MiguelHorta/SmartLeadCharger/presentation/Apresentação Carregador de Baterias.pptx

## Carregador Inteligente de Baterias de Chumbo

Projecto de Eletrónica IV - 4º Ano MIEEET

Professor: Rui Escadas
Autores: Edgar Gonçalves 67590
Miguel Horta 67597

## Objetivos:

- Construir um dispositivo autónomo e de fácil interação com o utilizador capaz de carregar baterias de forma o mais versátil possível;
- Não explodir nada.

## Protótipo:

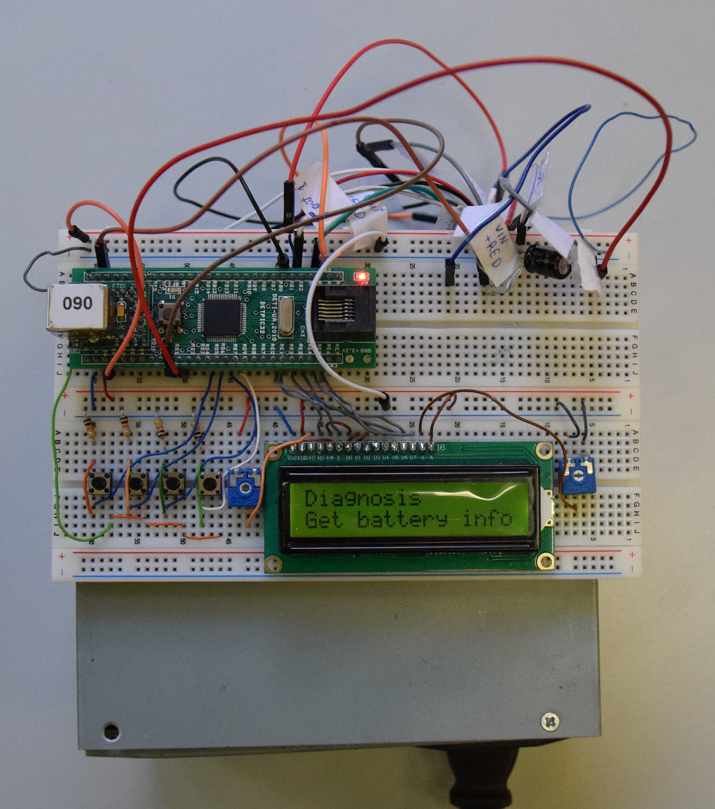
[picture p1: figure]

## Circuitos:

1. Acondicionamento de PWM;
2. Acondicionamento dos sensores de temperatura;
3. Regulador linear de tensão;
4. Fonte de potencia;
Extras:
5. Fonte de 24 V “reutilizada”.

## Acondicionamento de PWM

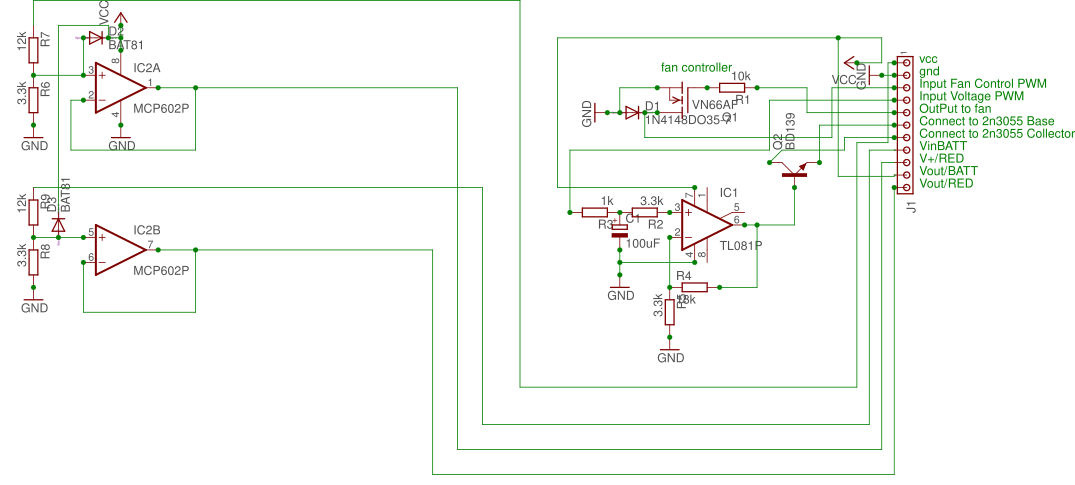
[picture p2: figure]

## Acondicionamento de PWM

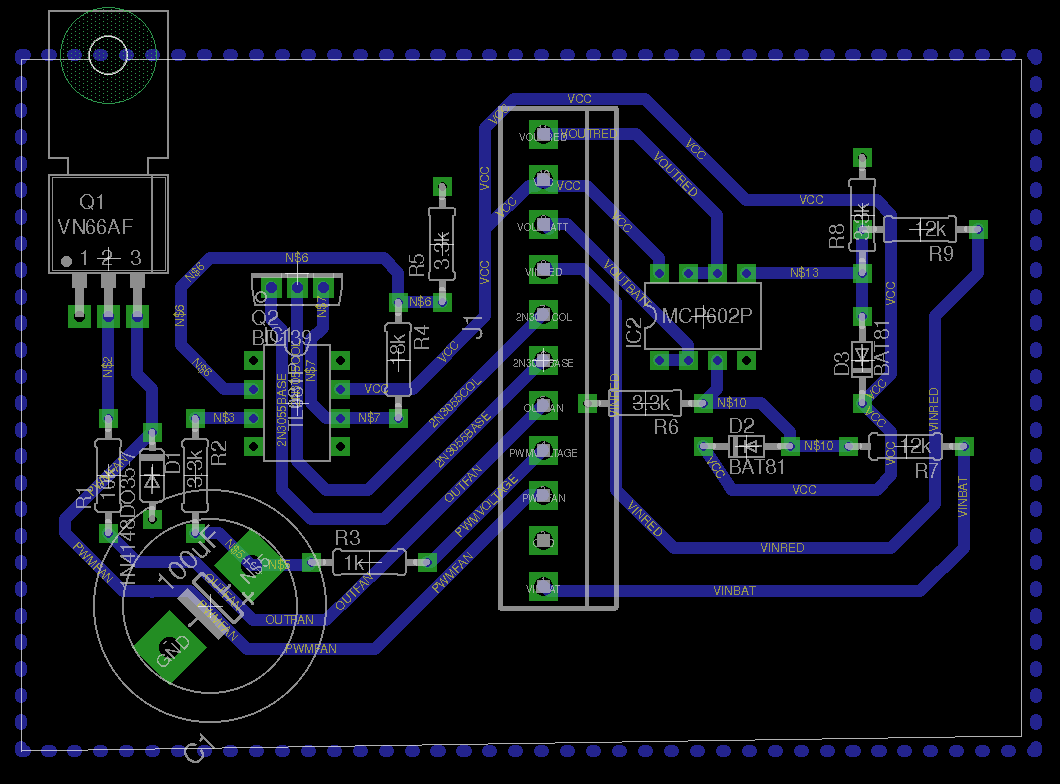
[picture p3: figure]

## Acondicionamento de PWM

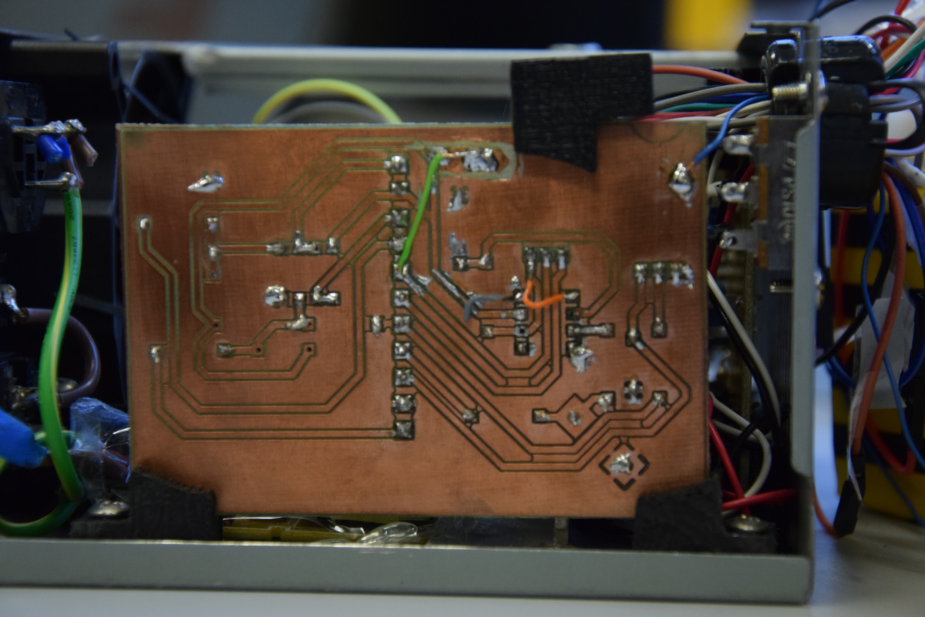
[picture p4: figure]

## 2. Acondicionamento dos sensores de temperatura

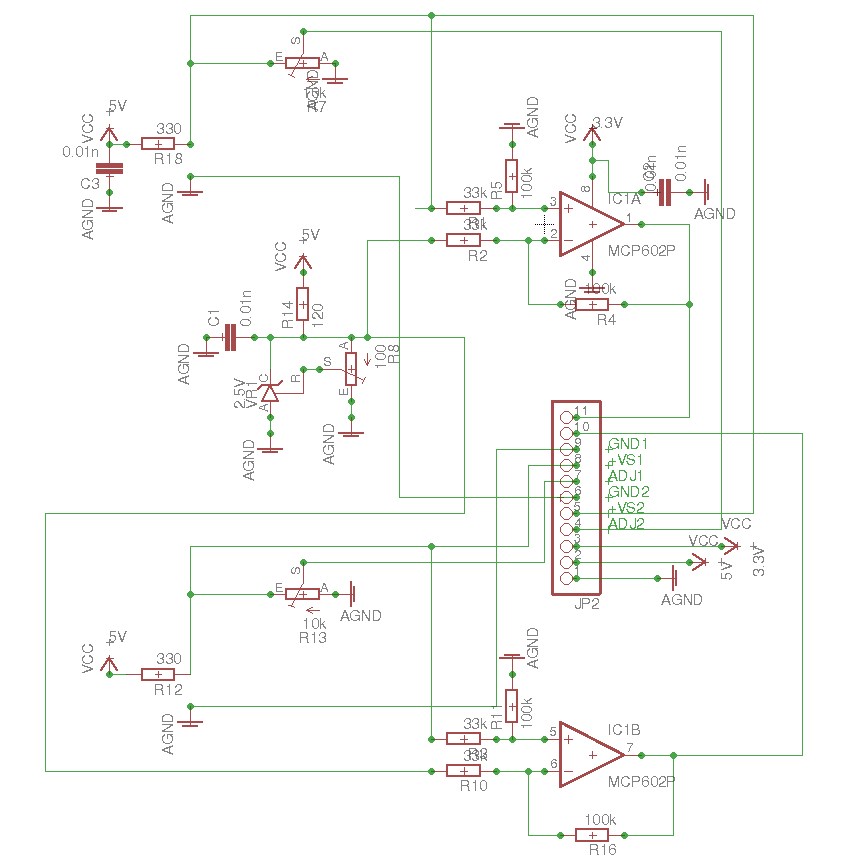
[picture p5: figure]

## 2. Acondicionamento dos sensores de temperatura

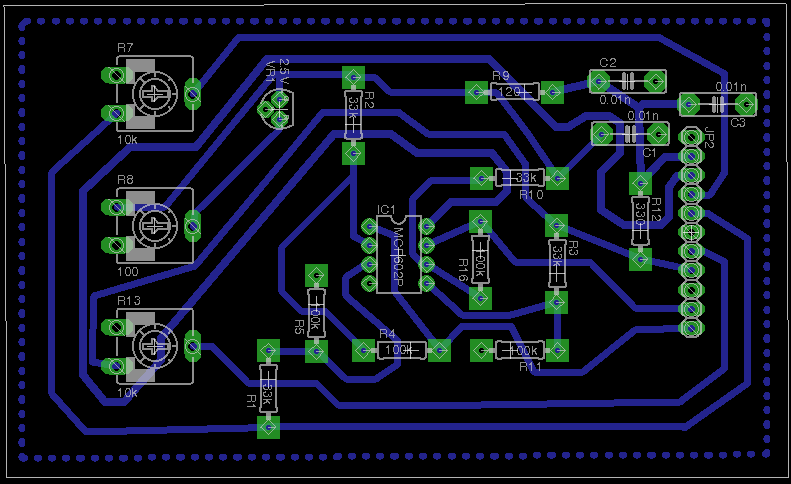
[picture p6: figure]

## 2. Acondicionamento dos sensores de temperatura

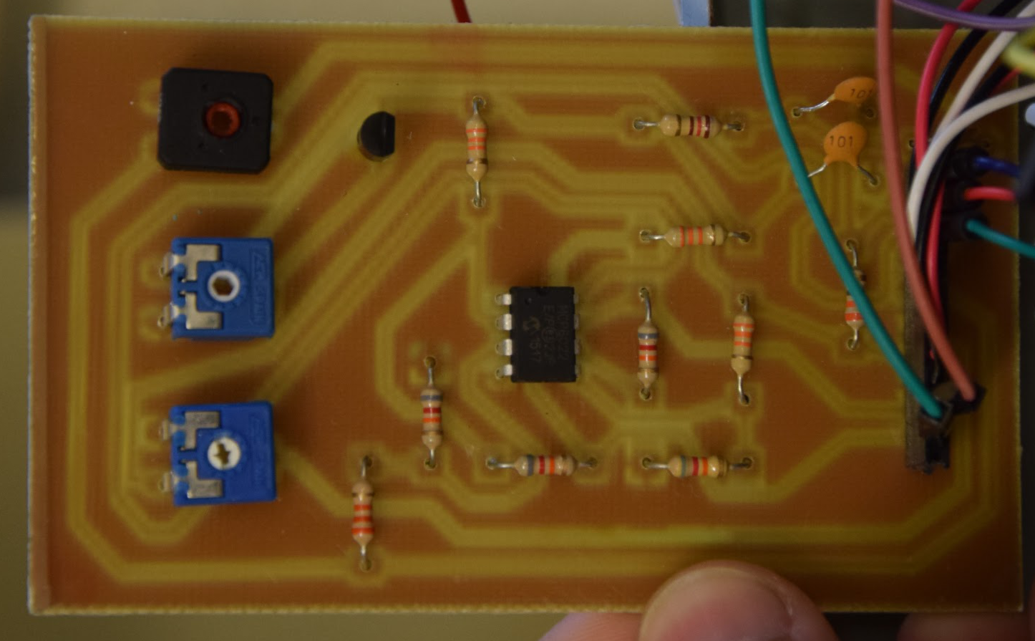
[picture p7: figure]

## 3. Medidor de corrente

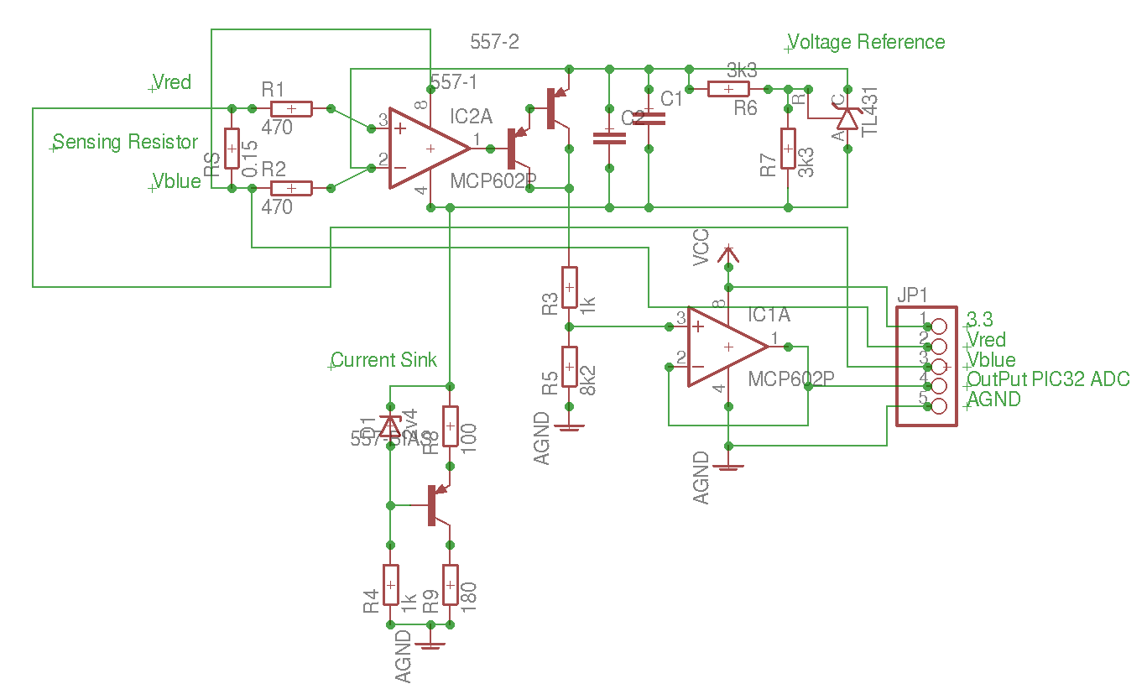
[picture p8: figure]

## 3. Medidor de corrente

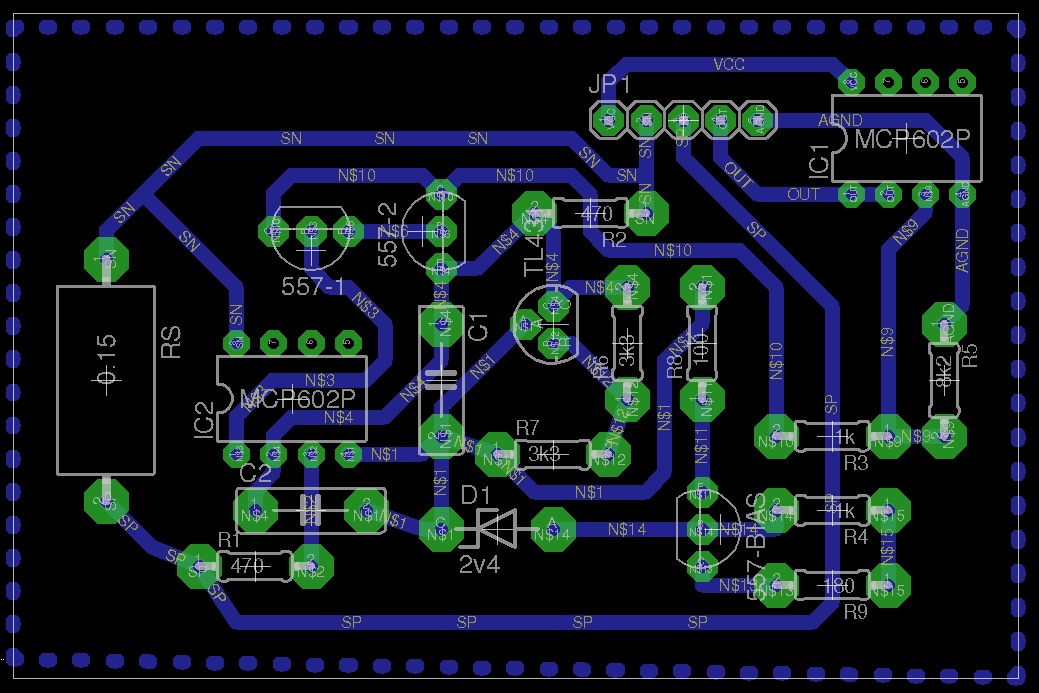
[picture p9: figure]

## 3. Medidor de corrente

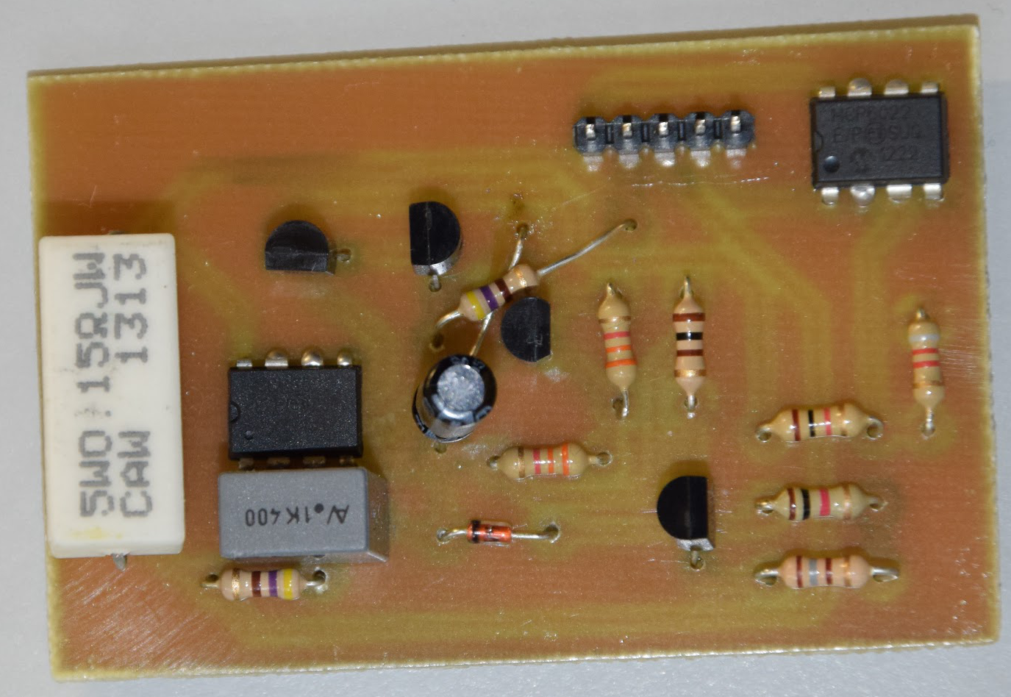
[picture p10: figure]

## 4. Regulador linear de tensão

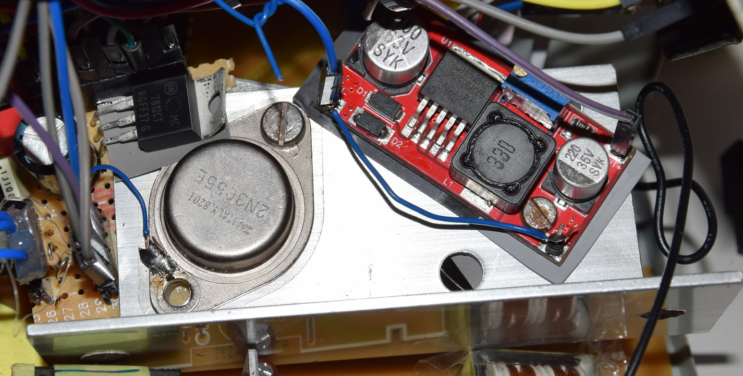
[picture p11: figure]

## 5. Fonte de 24 V “reutilizada”

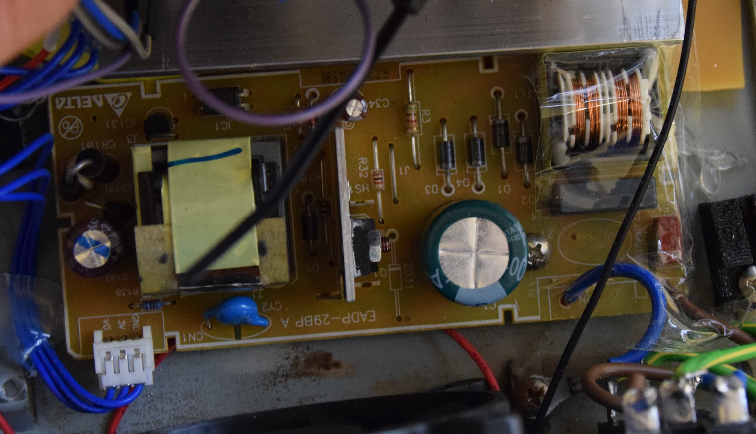
[picture p12: figure]

## Diagrama de Blocos

## Tipos de carregamento

1. “Smart Charge”;
2. “Fast Charge”;
3. “Slow Charge”.

## 1. Smart Charge

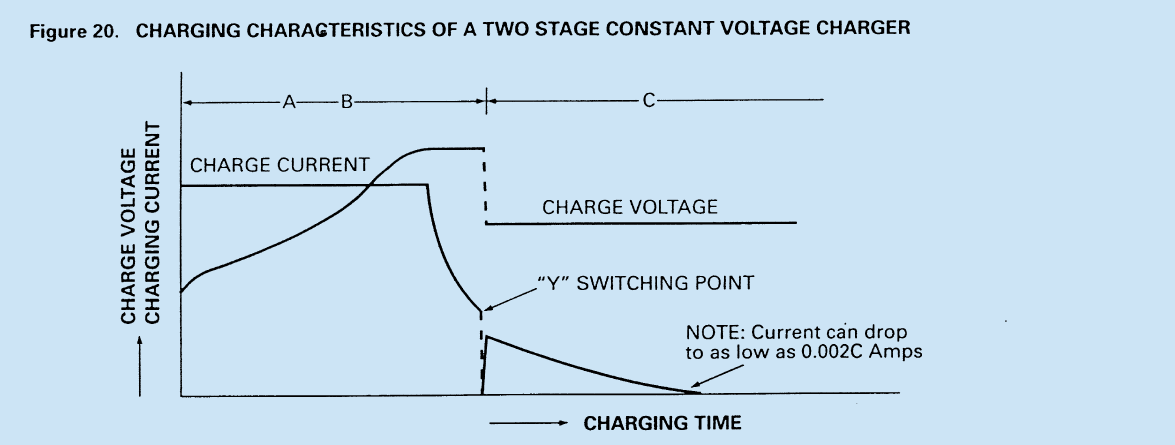
[picture p13: figure]

## 2. Fast Charge

- Máxima tensão que as especificações da bateria permitem
- Nenhuma limitação de corrente

## 3. Slow Charge

- Limitação de corrente para uma dada percentagem (10% CA) da capacidade total da bateria.

## Estrutura do código

Main:
Responsável pelo setup e configuração inicial e pela comunicação com o computador através da porta de série
ADC:
Scan das portas analógicas utilizadas. Funciona automaticamente e ininterruptamente atualizando uma estrutura de dados que faz média com os valores anteriores. Configurada para ser usada por interrupção.

## Estrutura do código

Timer2:
Timer 2 a 1kHz. Base de tempo para o PWM da base do regulador linear e da ventoinha.
Timer 4:
Timer 4 a 100Hz. Actualiza os valores das funções de controlo e disponibiliza-os aos atuadores.
Timer 5:
Timer 5 a 5Hz. Refresh rate do LCD e respectivo handling dos botões

## Estrutura do código

Charge Plan:
Contém toda a lógica para os diversos perfis de carregamento.
LCD e HD44780
Lógica de interação com o lcd e exposição do seu funcionamento.

## Conclusões/Dificuldades

- Testar as condições para a utilização pretendida poderia demorar entre oito a vinte e quatro horas por carga/descarga da bateria.
- Testar o alcance das várias temperaturas seria quase impossível no seu uso real pois teríamos que exceder os limites da bateria, o que muito provavelmente causaria o seu mau funcionamento.

## Próximo passo

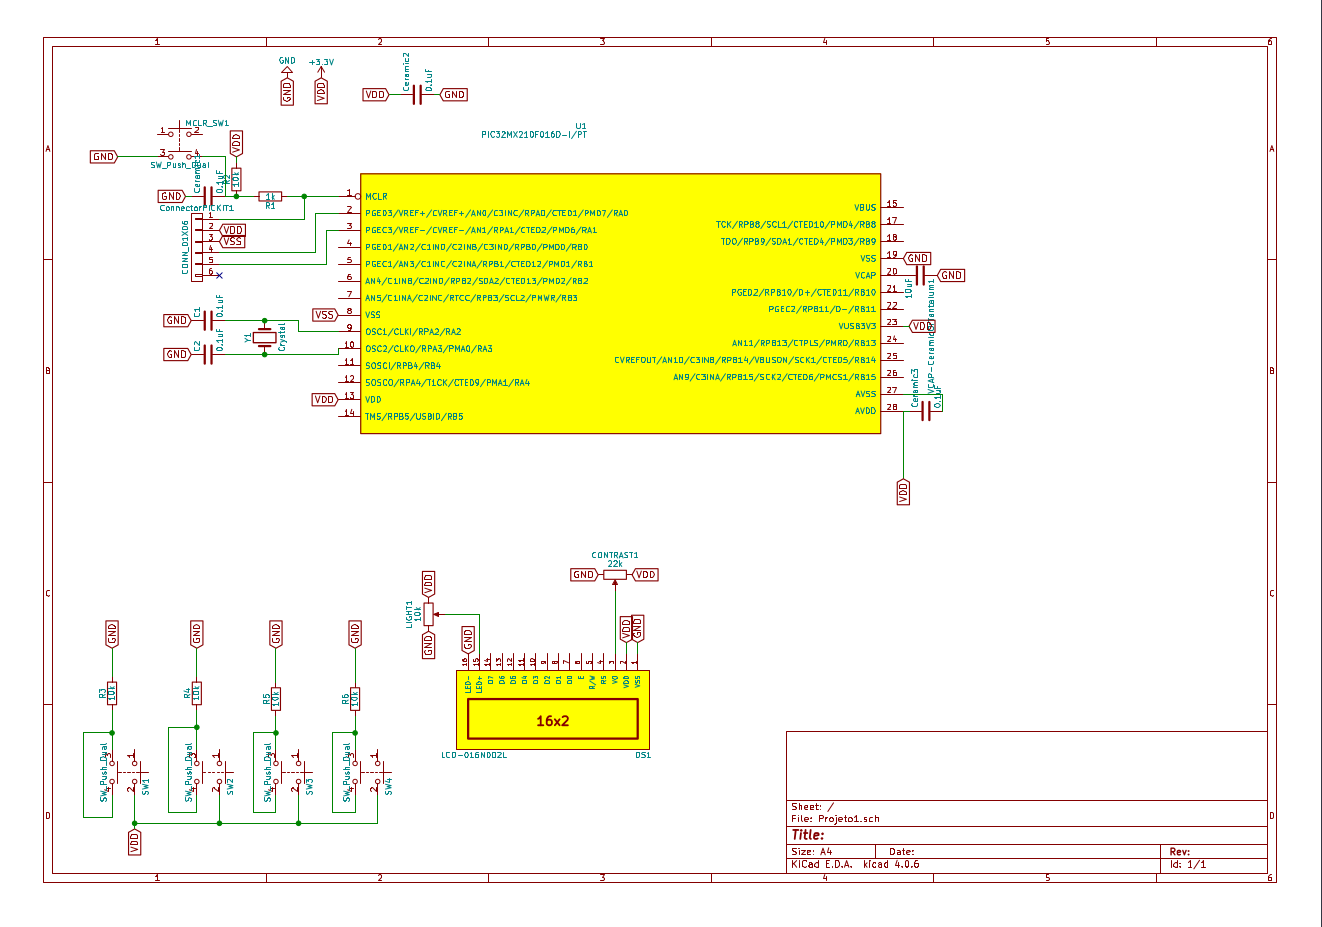
[picture p14: figure]

- Colocar os restantes componentes da breadboard para uma PCB dedicada com um µC PIC32MX210DF016;
- Implementar um circuito de descarga;
- Acrescentar memória para gravar os ciclos de uso.

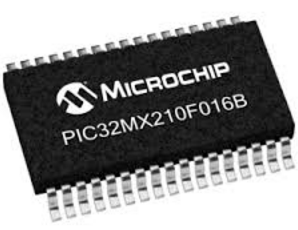
[picture p15: figure]

## Projecto no GitHub

https://github.com/MiguelHorta/SmartLeadCharger.git
