MiguelHorta/SmartLeadCharger/deliverables/Fase III/RelatoriFinal.pdf

## Electronica IV ´

Miguel Horta 67597 | Edgar Gonçalves 67590
I. INTRODUÇ AÕ

O presente documento explicita o desenho e construçao de ˜ um carregador de baterias de chumbo ”inteligente”.

II. OBJECTIVOS

Construir um dispositivo autonomo e de f ´ | acil interaç ´ | aõ
com o utilizador capaz de carregar baterias de chumbo de
forma o mais versatil poss ´ | ível. Este dispositivo devera ser ´
capaz de medir:
- a corrente fornecida a bateria, `
- a tensao fornecida ˜ | a bateria, `
- a tensao aos terminais da bateria (mesmo que n ˜ | ao es- ˜
teja a ser alimentada),
- a temperatura na face exterior da bateria,
- a temperatura da superfície do dissipador do regulador
linear de tensao no interior do m ˜ | odulo. ´

O micro controlador PIC32 incorporado no dispositivo atua, de acordo com as medidas anteriores e valores introduzidos pelo utilizador:

- na base do transistor de potencia do regulador linear ˆ
- na ventoinha que circula o ar do interior da estrutura do dispositivo
Em funçao das instruç ˜ | oes do utilizador e das medidas, as ˜
funcionalidades do dispositivo serao: ˜
- Calcular e apresentar a percentagem da restante carga da bateria,
- Carregar a bateria em 3 modos de funcionamento diferentes:
– Carregamento rapido - limitar a corrente apenas no ´ maximo especificado para a bateria, deteriorando a ´ saude da mesma em troca da velocidade de carrega- ´ mento,
– Carregamento lento - fixar uma corrente baixa, naõ deteriorando tanto a saude da bateria, ´
– Carregamento ”inteligente” - melhor relaçao ve- ˜ locidade de carregamento/preservaçao da bateria ˜ atraves de v ´ arios passos de carregamento diferentes ´ em funçao da percentagem de carga da bateria. ˜
- Apresentar os valores das diferentes medidas nas respectivas unidades,
- Impor em ”malha aberta”uma tensao a fornecer ˜ | a ba- `
teria,
- Impor em ”malha aberta”uma intensidade a ventoinha. `

III. PROJECTO E CALCULOS ´

A. Sensores de Temperatura

Este circuito adapta o sinal que e extra ´ ído do sensor de temperatura LM335 para uma gama de tensoes que seja ˜ lida pelos pins de entrada da PIC32 - 0 a 3.3V. Inicialmente o sinal esperado do terminal +VS do sensor de temperatura devera rondar os 2.9V para 20 ´

o
, usando um am-
plificador na configuraçao diferença com uma tens ˜ | ao de ˜
referencia de 2.73V no outro terminal de entrada do OP- ˆ AMP. Ajustando as resistencias consegue-se um ganho que ˆ adapte o sinal para valores que estejam sempre dentro da gama da PIC32. Neste caso, de forma a aproveitar o espaço, colocou-se o circuito dos dois sensores de temperatura (da bateria e interno da fonte) na mesma placa e no mesmo amplificador operacional MCP6022. Os sensores LM335 saõ suficientemente precisos para a utilizaçao desejada, foi es- ˜ colhido o amplificador operacional MCP6022 devido a ser rail-to-rail podendo assim obter uma boa excursao do sinal ˜ alimentando-o com a tensao regulada 3.3V da PIC32. ˜

A.1 Esquematico ´

A Figura 1 representa o esquematico deste circuito. ´
A Figura 4 representa a placa de circuito impresso deste circuito.
B. Mediçao de corrente ˜

Este circuito, inspirado no high-side current sense [1] da Intersil baseia-se na amostragem da queda de tensao aos ˜
terminais de uma resistencia de ˆ | 0.15Ω colocada em serie ´
com a linha de carregamento. Escolheu-se uma resistencia ˆ
de baixo valor para ter pouca influencia na tens ˆ | ao e para ˜
dissipar pouca energia. A corrente flui do terminal com o nome ”Vblue”para o ”Vred”, consoante o valor maior ou
menor dessa tensao, o darlington (de dois BC557) ˜ | a sa ` | ída
do amplificador operacional ira conduzir mais ou menos ´ corrente para o divisor resistivo composto pelas resistencias ˆ de 1kΩ e 8k2Ω, que volta a converter o sinal em tensao, ˜
apos um buffer ´ | e amostrado pela pic32. Uma caracter ´ | ística
deste circuito e o facto de n ´ | ao ter nenhuma refer ˜ | encia di- ˆ
recta a alimentaç ` | ao ou ˜ | a massa estando assim em ` | floating.
O custo associado a este benfício e a eletr ´ | onica adicional: ´
a alimentaçao do amplificador operacional ˜ | e atribu ´ | ída pela
tensao de refer ˜ | encia atrav ˆ | es do TL431, e uma fonte de cor- ´
rente para a alimentaçao negativa. ˜

B.1 Esquematico ´

A Figura 2 representa o esquematico deste circuito. ´
A Figura 5 representa a placa de circuito impresso deste circuito.
C. Mediçao de tens ˜ | oes ˜
As medidas das tensoes da bateria e da tens ˜ | ao fornecida ˜
pela fonte sao extra ˜ | ídas apenas com um divisor resistivo
para reduzir o sinal a uma escala compatível com a ADC da PIC32 e um buffer antes da respectiva entrada. Os díodos schottky previnem que algum pico de tensao afete a entrada ˜ do amplificador operacional (buffer neste caso).

C.1 Esquematico ´

Para fazer um melhor aproveitamento de recursos, incluiuse o circuito de acondicionamento do sinal de mediçao de ˜ tensoes e o de controlo de pwm na mesma placa. ˜
A Figura 3 representa o esquematico que inclui este cir- ´ cuito.
A Figura 6 representa a placa de circuito impresso que inclui este circuito.
D. Acondicionamento de PWM para atuadores
O ataque a base do 2N3055 ` | e feito atrav ´ | es de um trans ´ | ístor
BD139 criando uma configuraçaõ darlington. O sinal de PWM da PIC32 atravessa um filtro passa baixo constituído
pela resistencia de ˆ | 1kΩ e o condensador de 100µF. Este si-
nal agora (quase) contínuo e comparado e amplificado pelo ´ amplificador operacional ao ataque da base do BD139.

D.1 Esquematico ´

Para fazer um melhor aproveitamento de recursos, incluiuse o circuito de acondicionamento do sinal de mediçao de ˜ tensoes e o de controlo de pwm na mesma placa. ˜
A Figura 3 representa o esquematico que inclui este cir- ´ cuito.
A Figura 6 representa a placa de circuito impresso que inclui este circuito.
IV. APRESENTAÇ AÕ , ANALISE E ´ | DISCUSSAO DOS ˜

RESULTADOS

Para obtençao dos resultados foi usada uma bateria de ˜ chumbo de 6V ( 3celulas). ´
O objectivo principal da bateria e efectuar o modo de car- ´ regamento inteligente. Neste modo de carregamento, assumindo que a bateria nao est ˜ a carregada, o dispositivo for- ´ nece uma corrente fixa de 0.25C (Ampere) da bateria (introduzida pelo utilizador). No caso pratico estipulou-se que ´ a bateria de 6V tem 1000C(mA) logo a corrente fornecida
inicialmente e 250mA. Esta corrente ´ | e mantida neste valor ´
atraves de um controlador PI (Proporcional-Integral) imple- ´ mentado na PIC32. Mantendo a corrente fixa, a tensao aos ˜
terminais sobe gradualmente ate atingir 2.45V por c ´ | elula ´
(numero de c ´ | elulas introduzida pelo utilizador). Neste caso ´
a bateria tem 3 celulas logo o valor de tens ´ | ao m ˜ | aximo ´ | é
7.35V. Ao chegar a este valor, o dispositivo passa para o se-
gundo passo do carregamento: mantem este valor de tens ´ | aõ
ate a corrente ser menor que 0.05C, ou seja 50mA. ´ | A poste- `
riori, entra no ultimo estado, em que o carregador mant ´ | em´
a tensao nominal da bateria aos terminais da mesma - neste ˜ caso 6V.
Os resultados foram obtidos ao carregar uma bateria de 6V - note-se que estes resultados sao bastante demora- ˜
dos. Foram adquiridos atraves da obtenç ´ | ao dos valores ˜
pela porta serie, usando o programa SerialPlot [2]. Na fi- ´ gura 7 consegue-se observar que a corrente tem tendencia a ˆ manter-se sempre no valor desejado enquanto que a tensaõ aumenta ate certo ponto. Observa-se alguns picos principal- ´
mente na corrente que sao erros de medida e s ˜ | | | ao filtrados ˜
pelo software.
Na figura 9 observa-se o carregamento no seu segundo es-
tado em que a tensao mant ˜ | em-se no seu m ˆ | aximo enquanto ´
que a corrente baixa ate certo ponto. ´
Na figura 9 observa-se o ultimo passo no carregamento, ´
em que se mantem uma tens ˆ | ao pr ˜ | oxima da tens ´ | ao nominal ˜
aos terminais da bateria.
V. CONCLUSOES E TRABALHO FUTURO ˜

No geral, o dispositivo a que chegamos cumpre os requi- ´ sitos inicialmente estabelecidos. As medidas sao realizadas ˜
com uma precisao razo ˜ | avel, os atuadores funcionam dentro ´
de um intervalo aceitavel, a temperatura interna mant ´ | em- ˆ
se dentro dos limites desejados, tem uma interface intuitiva e pormenorizada com o utilizador, apresenta detalhes que permitem chegar a um dispositivo eletricamente seguro nomeadamente ligaçaõ a terra e, temporalmente o controlo do `
estado interno e previs ´ | ível.
Uma desvantagem obvia deste trabalho ´ | e a morosidade da ´
emulaçao das condiç ˜ | oes reais a que o aparelho iria estar ˜
submetido, consequentemente teve que se tomar a via de apenas realizar exaustivamente pequenos testes com cargas simuladas, sendo que falhas que possam advir dos longos períodos de funcionamento a que o aparelho ficara sujeito ´ nesses ambientes, poderao ter ficado por ser descobertas. ˜ Em termos de software, seguiu-se uma abordagem mais baseada em eventos e interrupçoes, o que nos obrigou a ˜ maior esforço para garantir consistencia e previsibilidade ˆ temporal. O codigo ´ e todo original, excepto a biblioteca ´ usada para a interface com o LCD que e baseada na biblio- ´ teca desenvolvida para as placas STM [3] para esse mesmo proposito. ´
O software ficou bem organizado e estruturado permitindo
a introduçao de novas ˜ | features no futuro.
Em retrospectiva, fomos demasiado longe para alem da- ´ quilo que foi proposto, acabando por ficarmos sobrecarregados e com falta de tempo para chegar a qualidade preten- ` dida.
O projecto neste momento cumpre todos os requisitos a que inicialmente nos propusemos, no entanto ao longo ´ do desenvolvimento do dispositivo fomos reunindo um conjunto de funcionalidades para implementaçao a longo ˜ prazo, nomeadamente:
- Comunicaçao sem fios atrav ˜ | | es de ´ | wifi ou bluetooth
- Adaptar a outras tecnologias de baterias
- Desenvolver uma placa de controlo dedicada de forma a remover a dependencia da DETPIC e melhorar a ˆ estetica ´
- Avisos sonoros

VI. ANEXOS

A. Sensores de temperatura

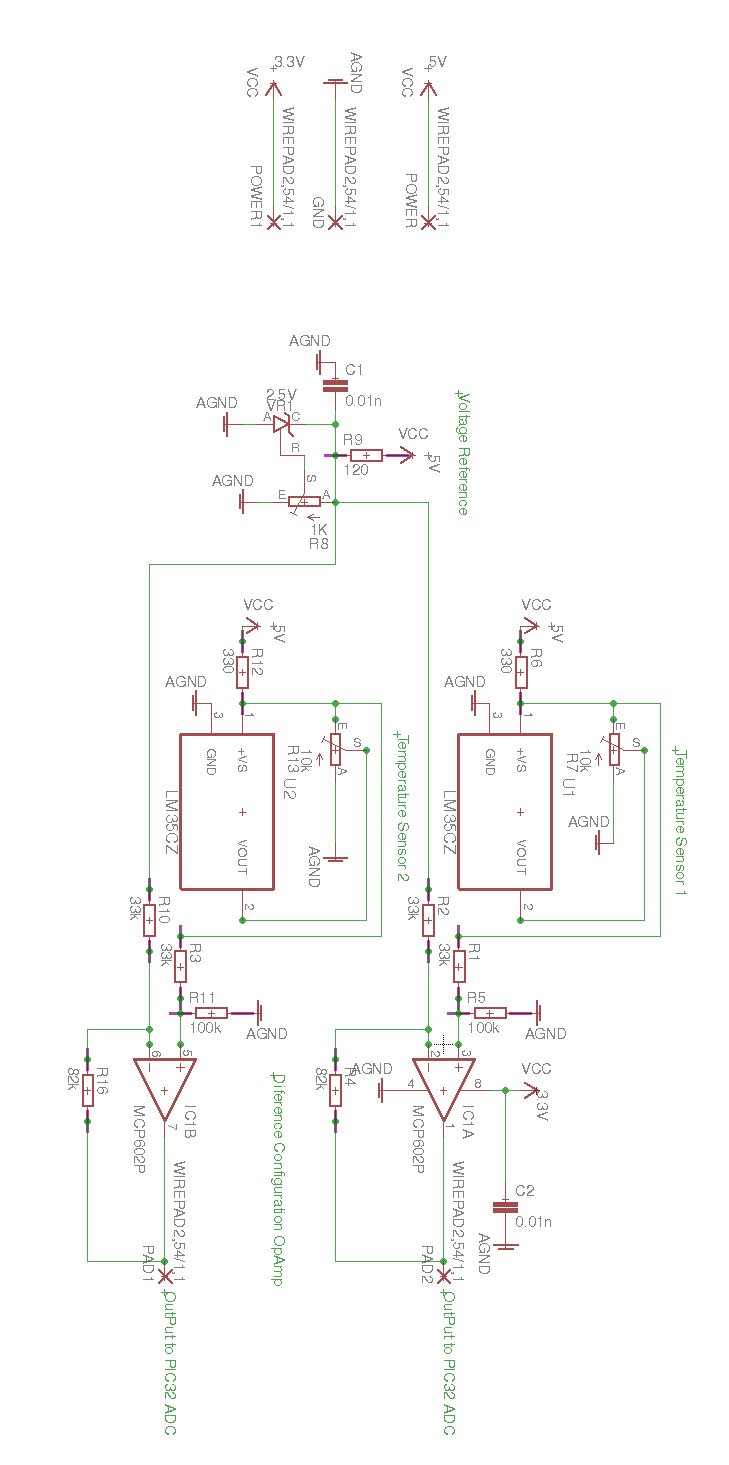
[picture p16: figure]

Fig. 1 - Acondicionamento do sinal dos sensores de temperatura para leitura pela PIC32.

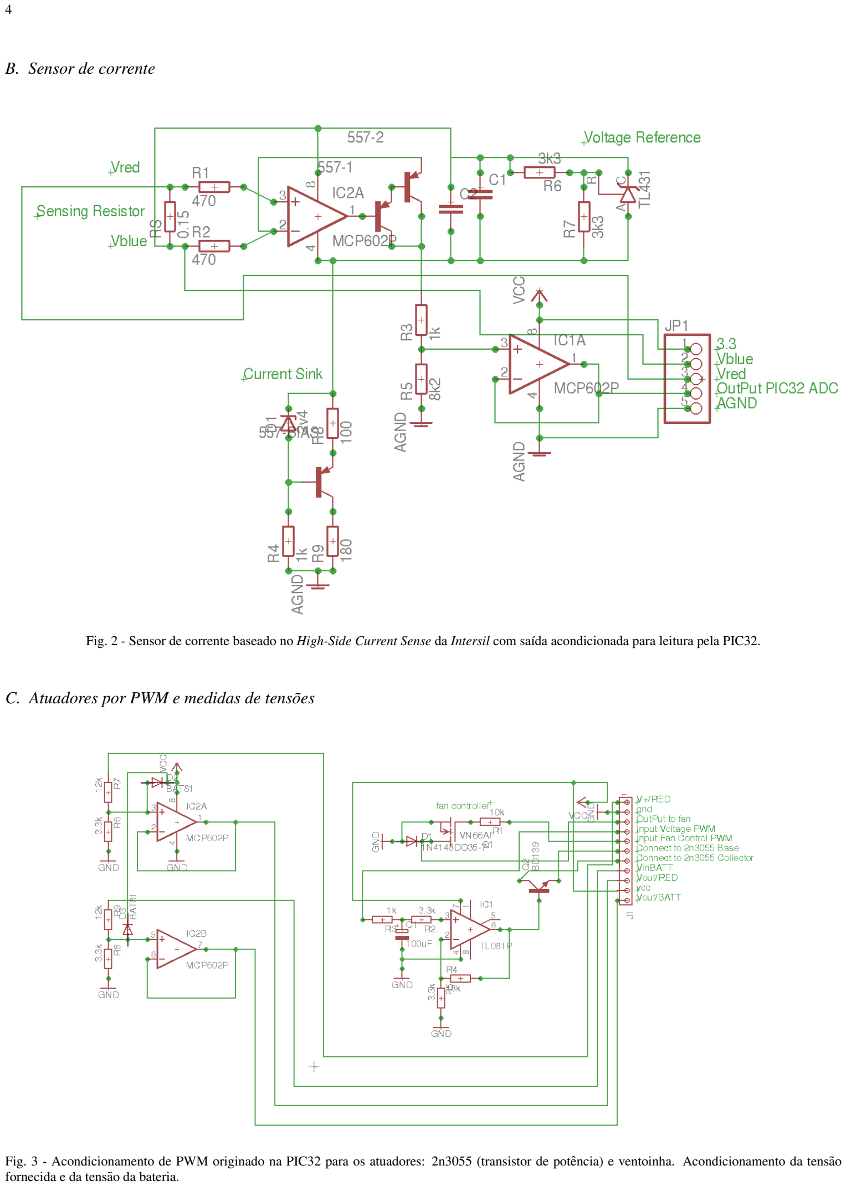
[picture p17: page 4]

B. Sensor de corrente

Fig. 2 - Sensor de corrente baseado no High-Side Current Sense da Intersil com saída acondicionada para leitura pela PIC32.

C. Atuadores por PWM e medidas de tensoes ˜
Fig. 3 - Acondicionamento de PWM originado na PIC32 para os atuadores: 2n3055 (transistor de potencia) e ventoinha. Acondicionamento da tens ˆ | aõ
fornecida e da tensao da bateria. ˜

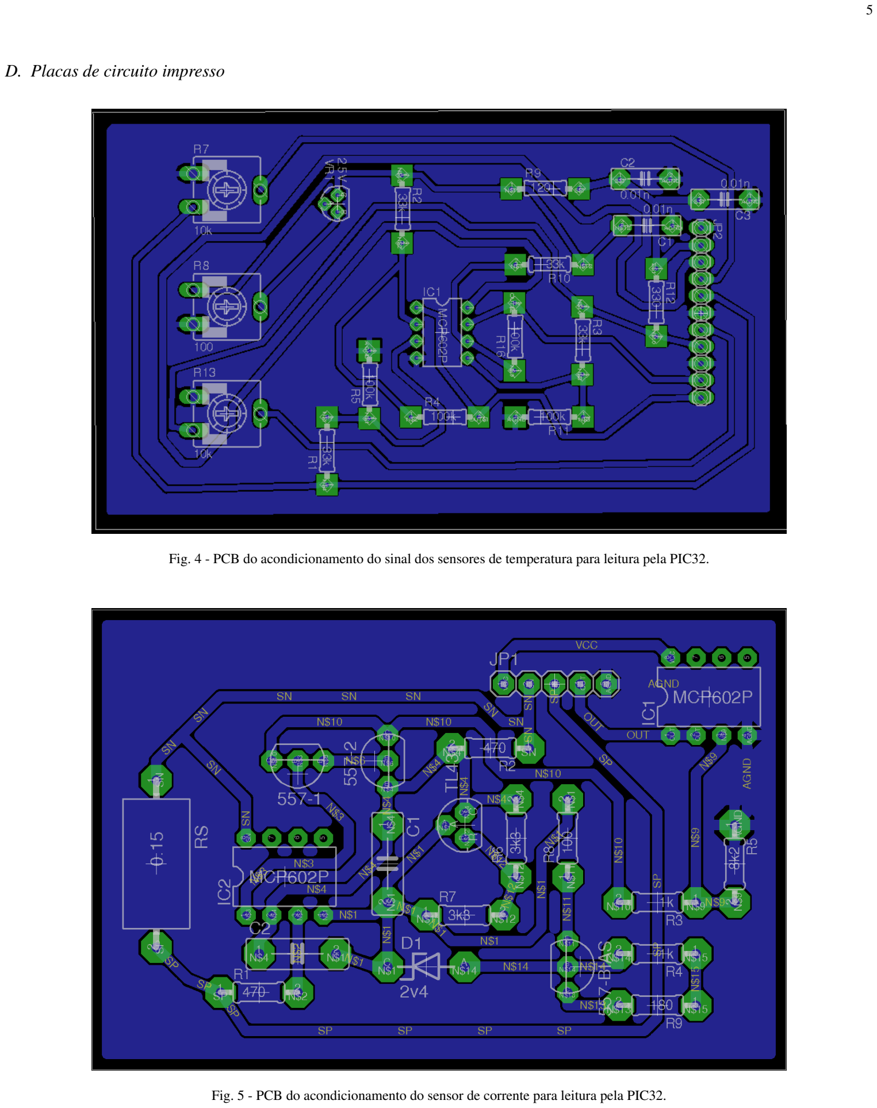
[picture p18: page 5]

D. Placas de circuito impresso

Fig. 4 - PCB do acondicionamento do sinal dos sensores de temperatura para leitura pela PIC32.

Fig. 5 - PCB do acondicionamento do sensor de corrente para leitura pela PIC32.

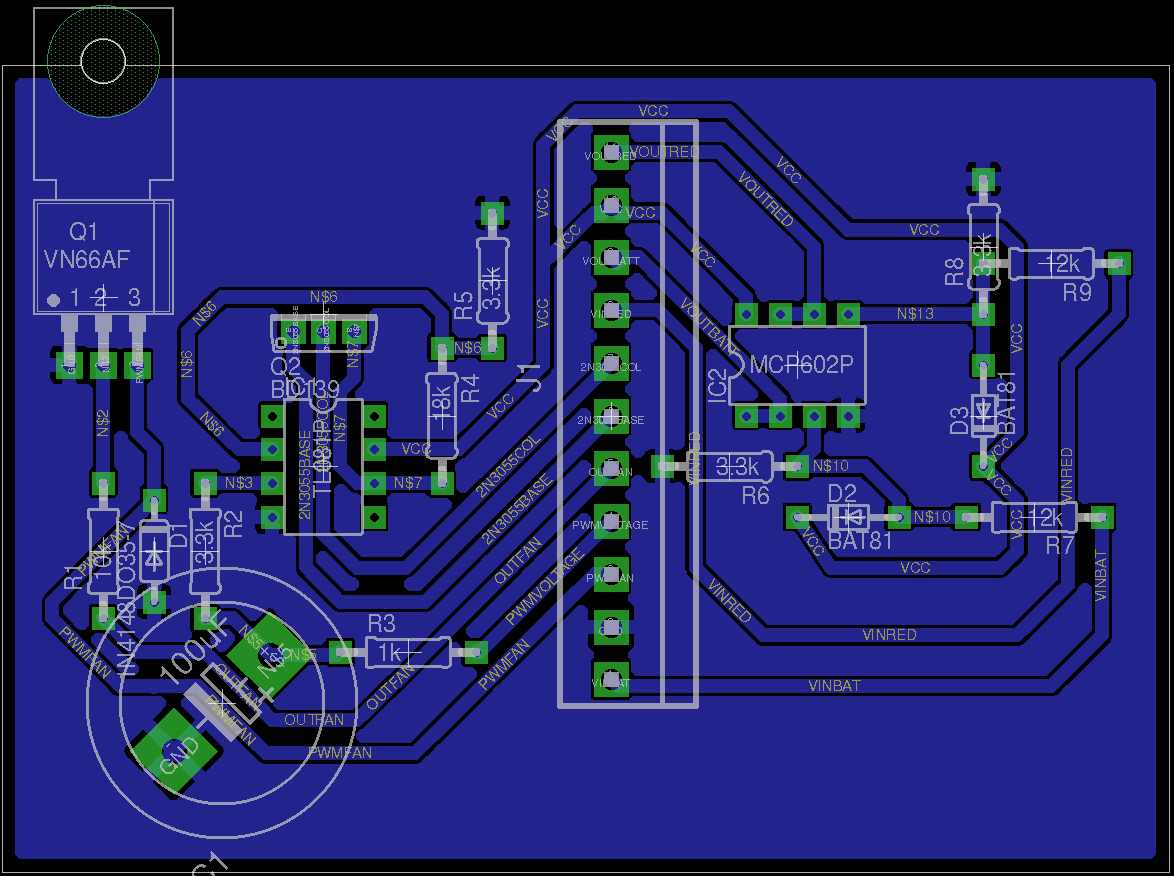
[picture p19: figure]

Fig. 6 - PCB do acondicionamento dos sinais de PWM para os atuadores e das leituras de tensaõ

BIBLIOGRAFIA

[1] Intersil, “Precision analog cookbook”.
URL: | https://web.archive.org/web/20140327021225/http://www.intersil.com/content/dam/Intersil/

collateral/en/cookbooks/st-091.pdf
[2] Hasan Yavuz OZDERYA, “Serial plot”. ¨

URL: https://bitbucket.org/hyOzd/serialplot/

[3] Tilen Majerle, “Stm libraries (for hd44780)”.

URL: https://github.com/MaJerle/stm32f429

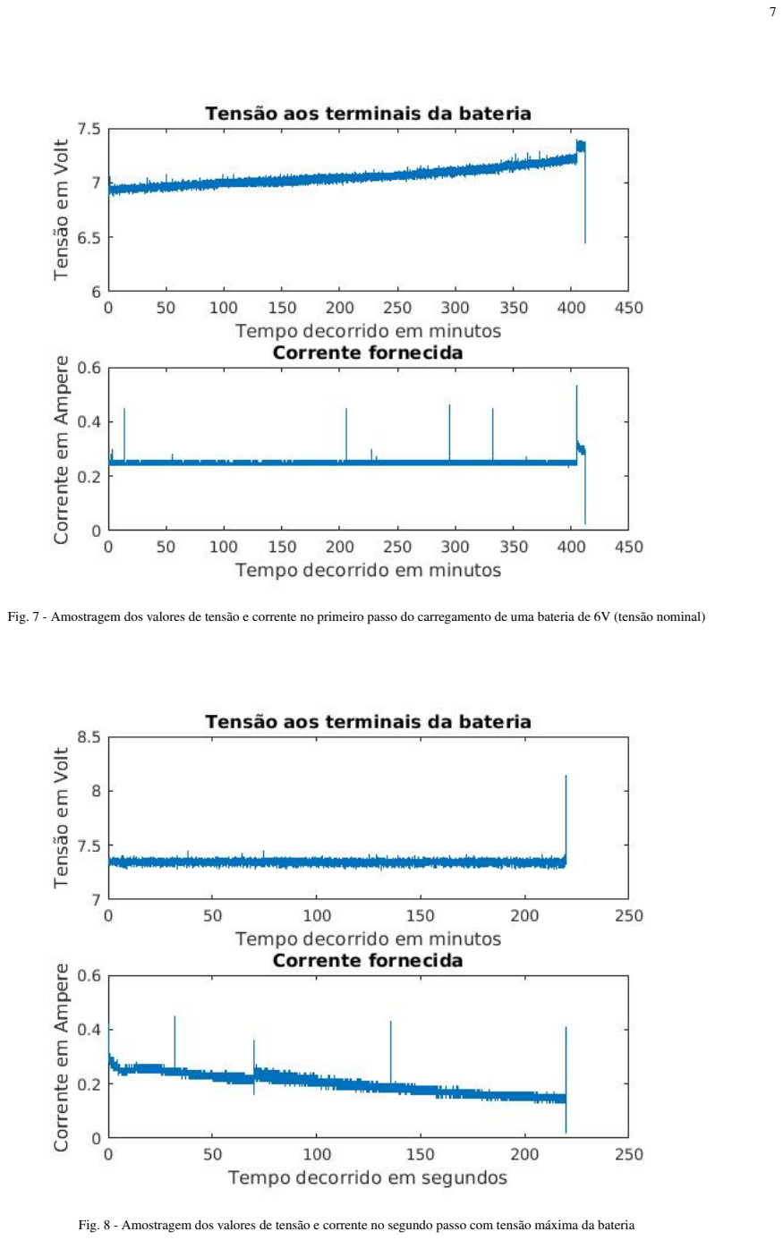
[picture p20: page 7]

Fig. 7 - Amostragem dos valores de tensao e corrente no primeiro passo do carregamento de uma bateria de 6V (tens ˜ | ao nominal) ˜
Fig. 8 - Amostragem dos valores de tensao e corrente no segundo passo com tens ˜ | ao m ˜ | axima da bateria ´

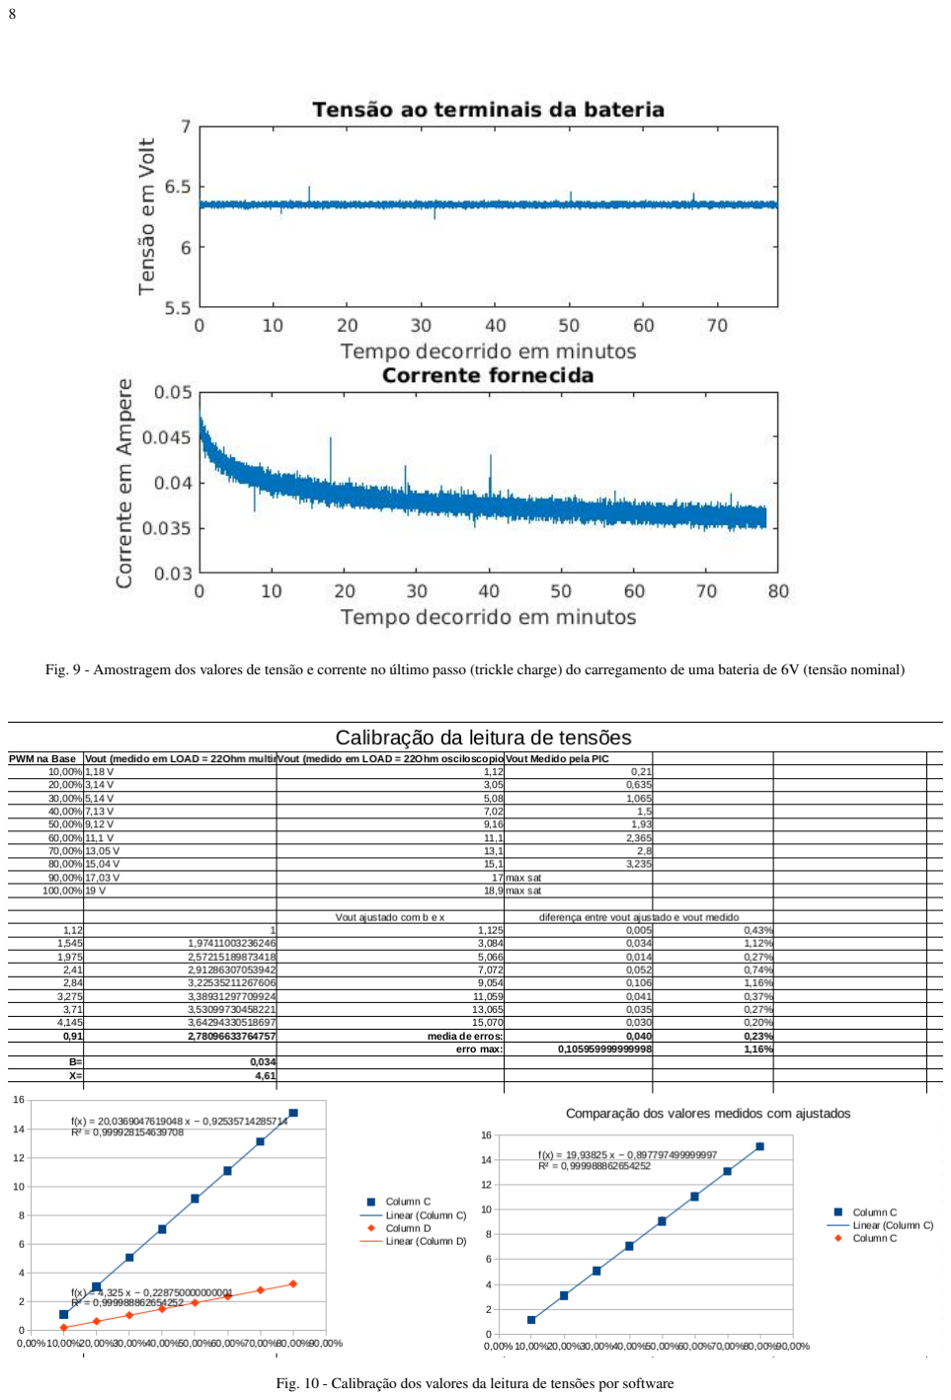
[picture p21: page 8]

Fig. 9 - Amostragem dos valores de tensao e corrente no ˜ | ultimo passo (trickle charge) do carregamento de uma bateria de 6V (tens ´ | ao nominal) ˜
Fig. 10 - Calibraçao dos valores da leitura de tens ˜ | oes por software ˜

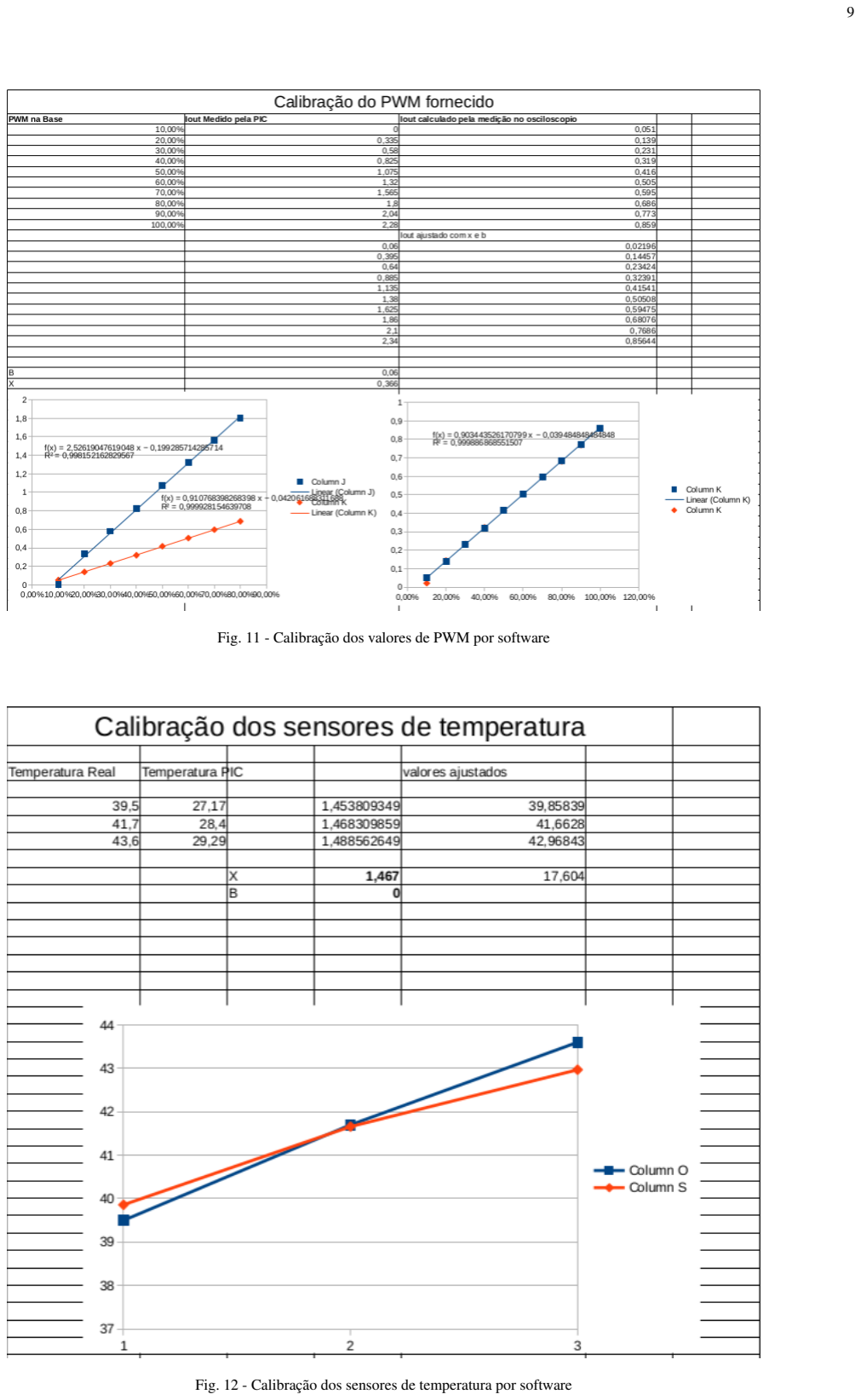
[picture p22: page 9]

Fig. 11 - Calibraçao dos valores de PWM por software ˜

Fig. 12 - Calibraçao dos sensores de temperatura por software ˜
