MiguelHorta/SmartLeadCharger/eagle_schematics/DRC.png

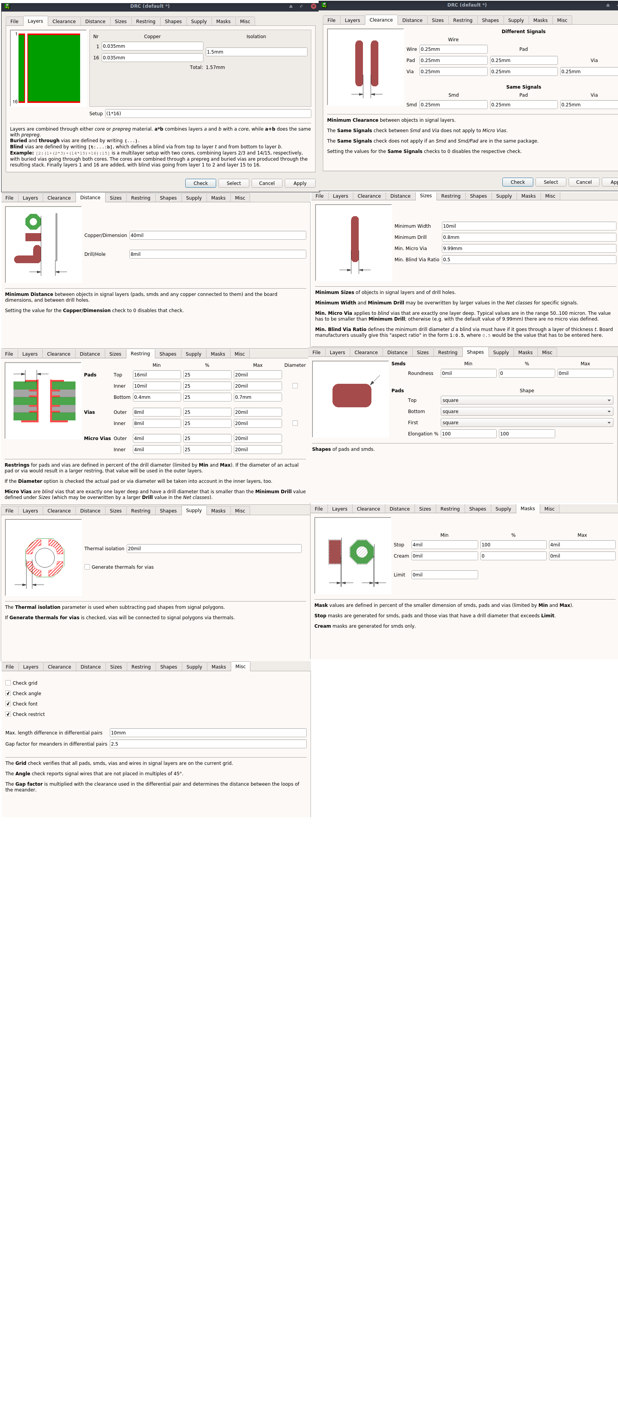
eagle_schematics/DRC.png
