MiguelHorta/SmartLeadCharger/3Dmodel/Botão.fcstd

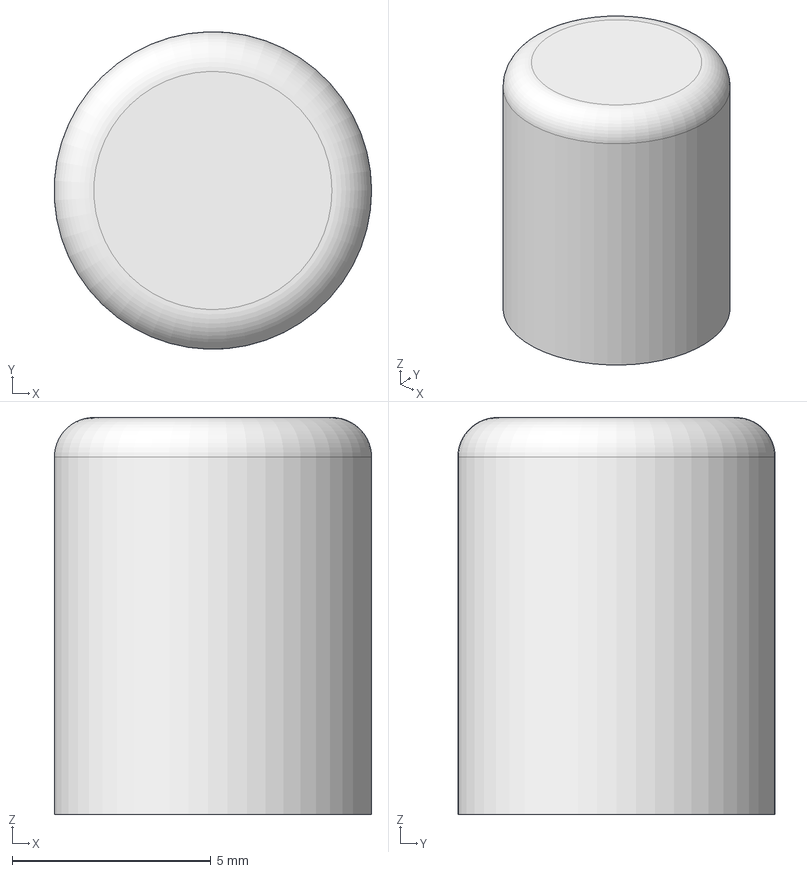
[picture p24: CAD file, 2017-06-23]
3Dmodel/Botão.fcstd
7.99 x 8.00 x 10.0 mm
