MiguelHorta/SmartLeadCharger/3Dmodel/ComeBananas.fcstd

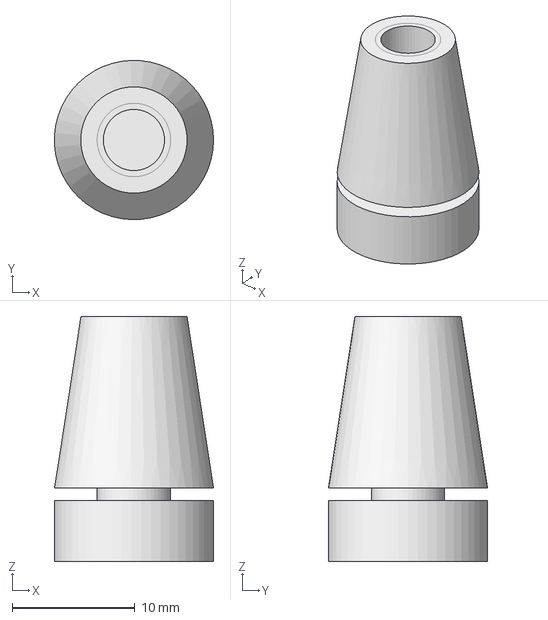
[picture p25: CAD file, 2017-06-23]
3Dmodel/ComeBananas.fcstd
13.0 x 13.0 x 20.0 mm
