MiguelHorta/SmartLeadCharger/3Dmodel/PSATX.fcstd

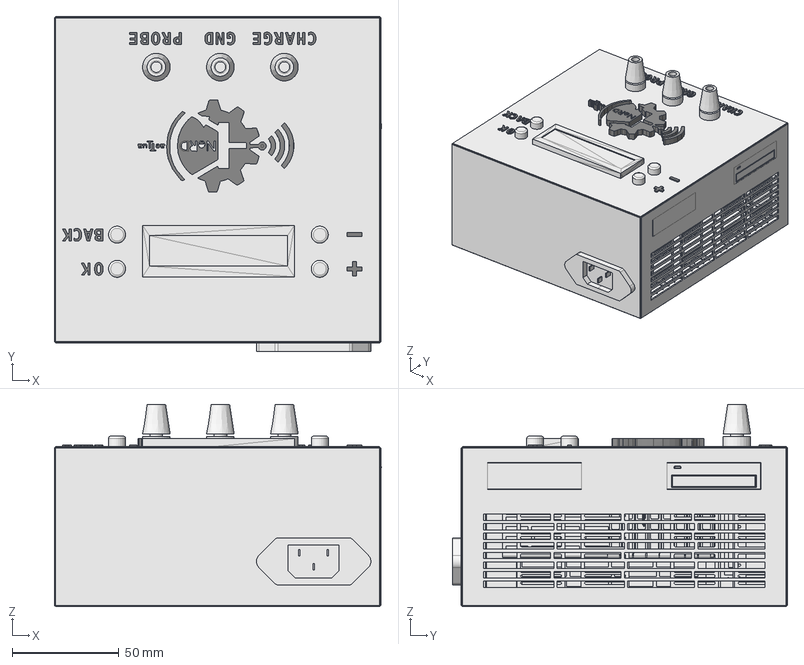
[picture p26: CAD file, 2017-06-23]
3Dmodel/PSATX.fcstd
153.3 x 157.0 x 94.9 mm
LCD_01
Clone of Fusion
charge
gnd
probe
+
ok
cancel
Cutout
