MiguelHorta/SmartLeadCharger/3Dmodel/LCD.fcstd

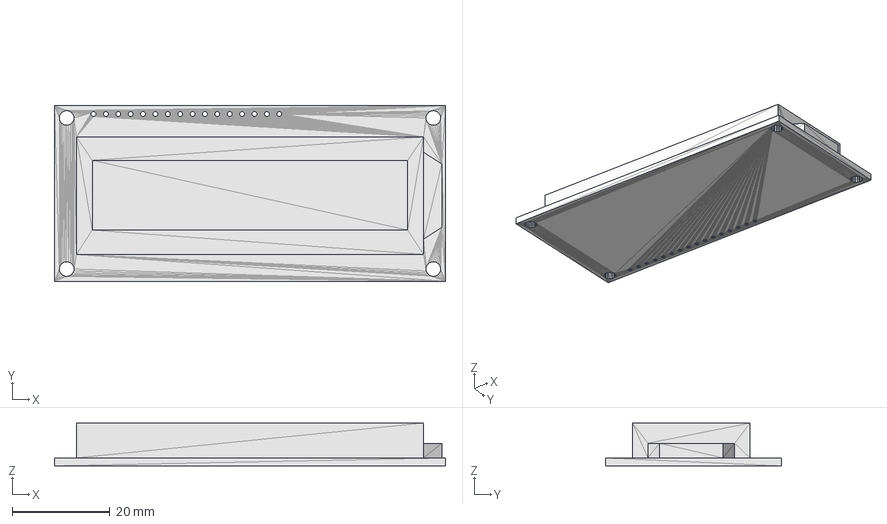
[picture p27: CAD file, 2017-06-23]
3Dmodel/LCD.fcstd
80.2 x 36.0 x 8.80 mm
