MiguelHorta/SmartLeadCharger/3Dmodel/E4Tetus.stl

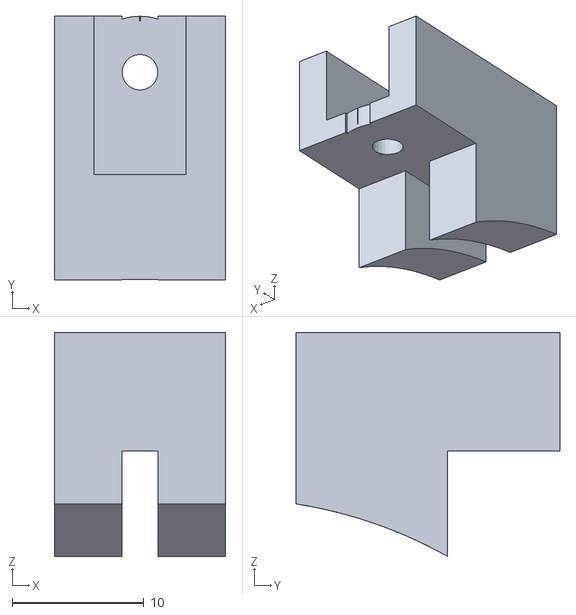
[picture p28: CAD file, 2017-06-01]
3Dmodel/E4Tetus.stl
13.0 x 20.0 x 17.0
