MiguelHorta/SmartLeadCharger/(list of files, cad)

Other CAD files:
3Dmodel/LCD.stl
