MiguelHorta/SmartLeadCharger/eagle_schematics/current-sense.brd

## EAGLE design eagle_schematics/current-sense.brd (2017-06-23)

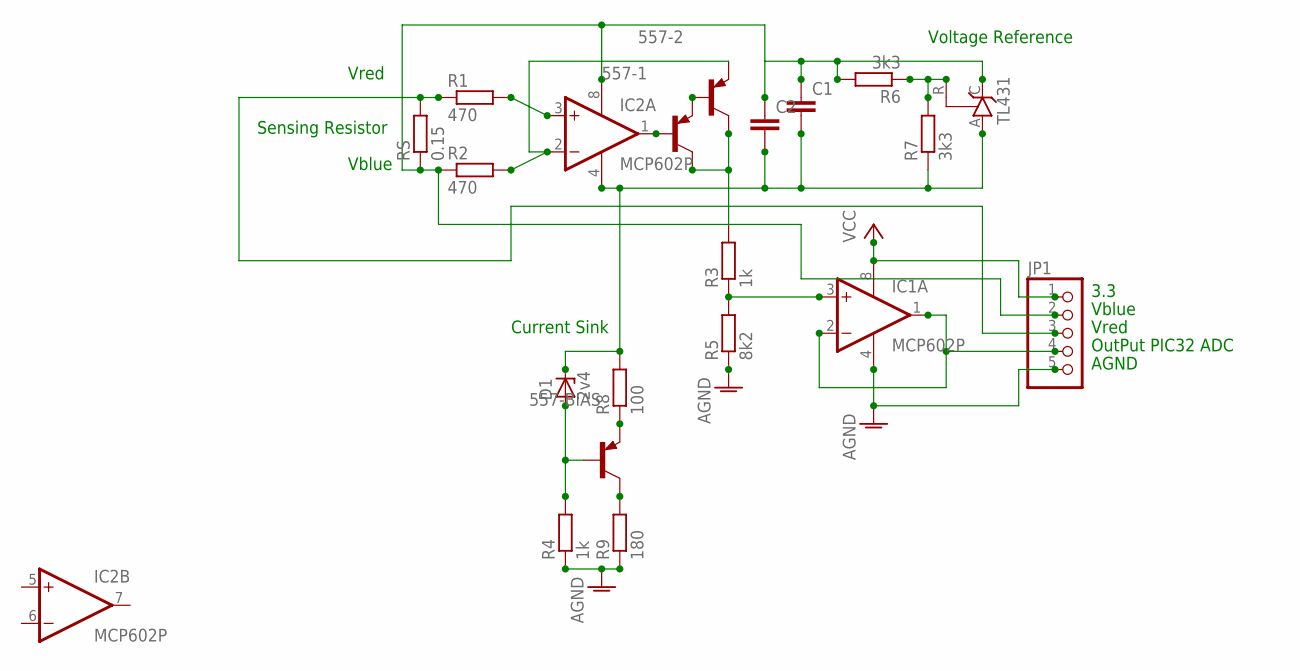
[picture p56: schematic current-sense.sch]

Parts:
557-1, 557-2, 557-BIAS: BC557A-PNP-TO92-EBC; TO92-EBC
C1, C2: C-EU075-032X103; C075-032X103
D1: 2v4; ZDIO-7.5
IC1, IC2: MCP602P; DIL08
JP1: PINHD-1X5; 1X05
R1, R2: 470; 0204/7
R3, R4: 1k; 0204/7
R5: 8k2; 0204/7
R6, R7: 3k3; 0204/7
R8: 100; 0204/7
R9: 180; 0204/7
RS: 0.15; VTA55
TL431: TL431CLP; TO92-CLP

Connections:
AGND: IC1.4 (V-), JP1.5, R5.1
unnamed: C1.2, C2.2, D1.C, IC2.4 (V-), R7.1, R8.2, TL431.A
unnamed: IC2.3 (+IN), R1.2
unnamed: 557-1.B, IC2.1 (OUT)
unnamed: 557-2.E, IC2.2 (-IN), R2.2
unnamed: 557-1.E, 557-2.B
unnamed: IC1.3 (+IN), R3.1, R5.2
unnamed: 557-1.C, 557-2.C, R3.2
unnamed: 557-BIAS.E, R8.1
unnamed: R6.1, R7.2, TL431.R
unnamed: 557-BIAS.C, R9.2
unnamed: 557-BIAS.B, D1.A, R4.2
unnamed: R4.1, R9.1
OUT: IC1.1 (OUT), IC1.2 (-IN), JP1.4
SN: C1.1, C2.1, IC2.8 (V+), JP1.2, R2.1, R6.2, RS.1, TL431.C
SP: JP1.3, R1.1, RS.2
VCC: IC1.8 (V+), JP1.1

Notes on the sheet:
3.3
AGND
OutPut PIC32 ADC
Vblue
Vred
Current Sink
Voltage Reference
Sensing Resistor

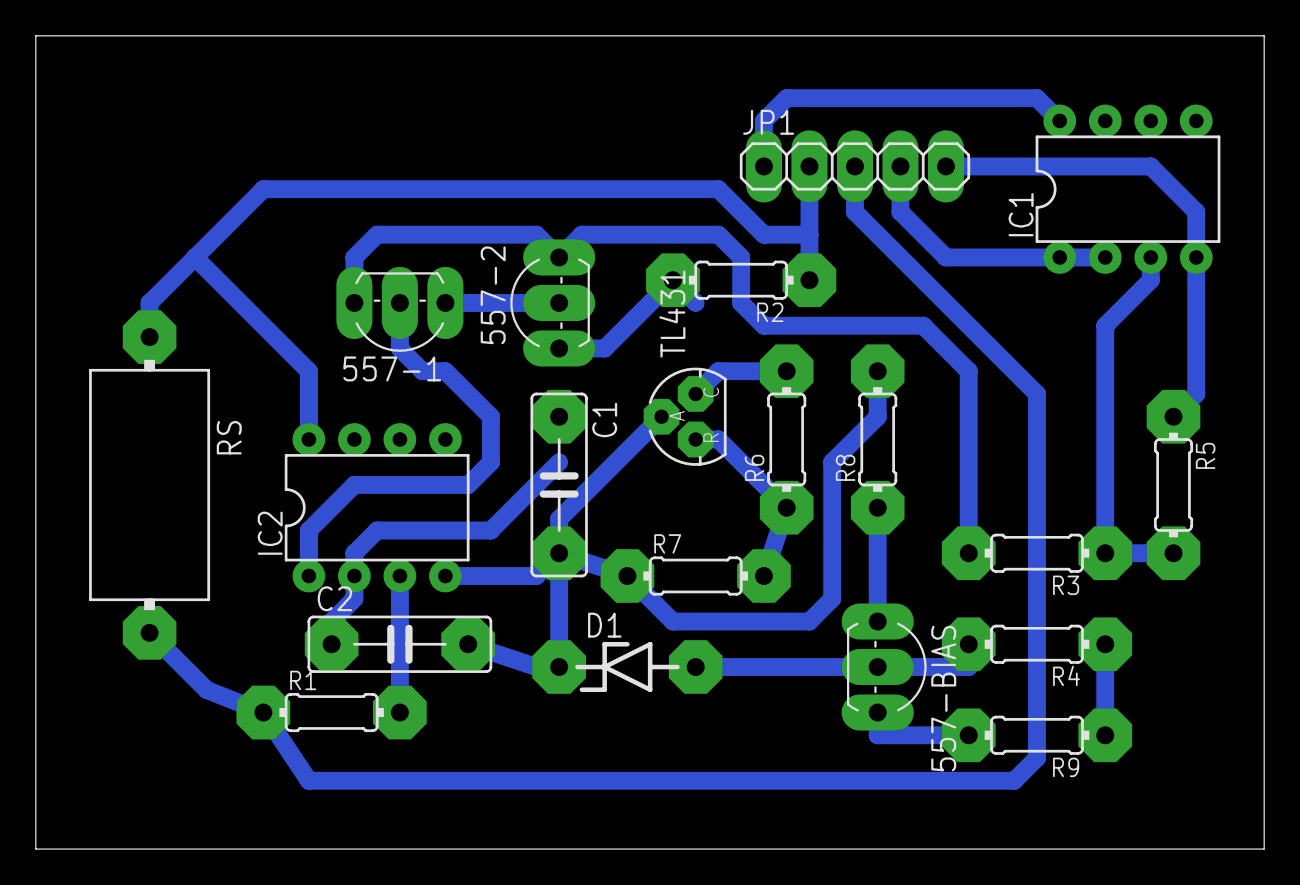
[picture p57: board current-sense.brd from above]

Board: 2 copper layers, 68.6 x 45.4 mm, 20 parts (0 on the bottom side), 17 nets.
