MiguelHorta/SmartLeadCharger/eagle_schematics/pwmControl.brd

## EAGLE design eagle_schematics/pwmControl.brd (2017-06-23)

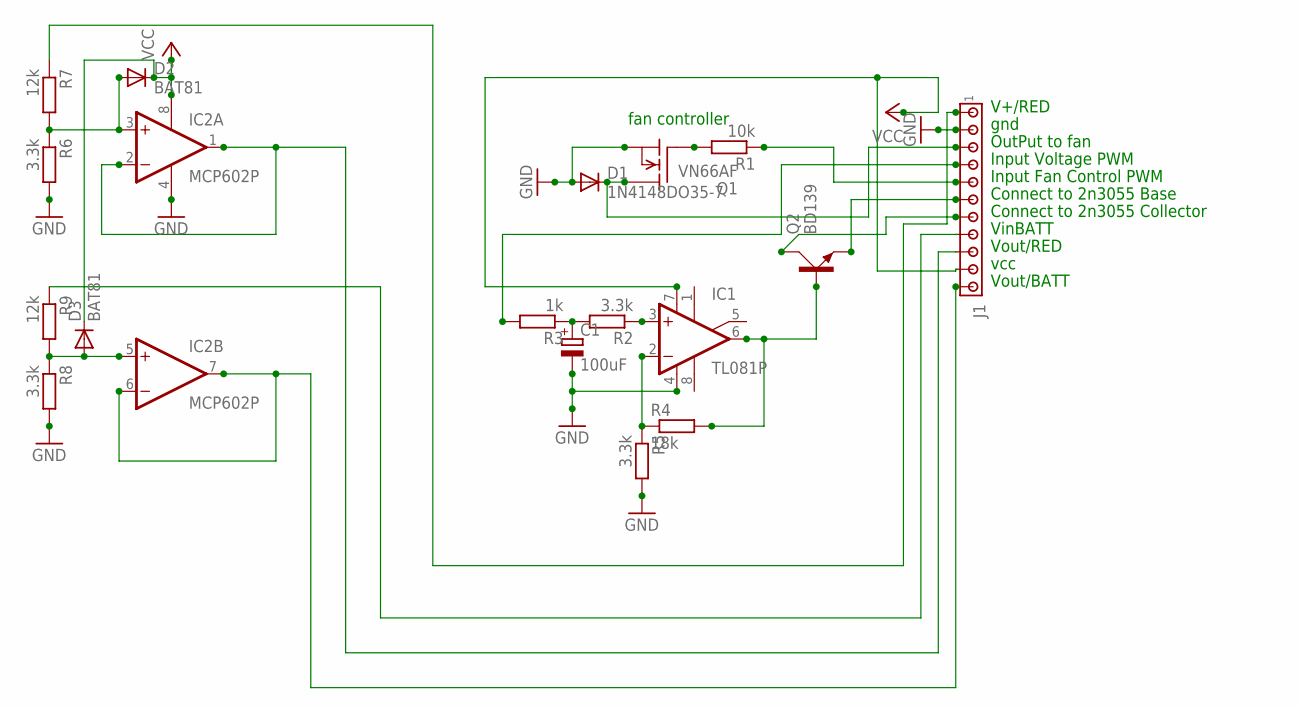
[picture p58: schematic pwmControl.sch]

Parts:
C1: 100uF; EB20D
D1: 1N4148DO35-7; DO35-7
D2, D3: BAT81; DO34-7
IC1: TL081P; DIL08
IC2: MCP602P; DIL08
J1: MTA11-156; 1X11MTA
Q1: VN66AF; TO202
Q2: BD139; TO126AV
R1: 10k; 0207/10
R2, R5, R6, R8: 3.3k; 0207/10
R3: 1k; 0207/10
R4: 18k; 0207/10
R7, R9: 12k; 0207/10

Connections:
2N3055BASE: J1.6, Q2.E
2N3055COL: J1.7, Q2.C
GND: C1.-, D1.A, IC1.4 (V-), IC2.4 (V-), J1.2, Q1.1 (S), R5.2, R6.2, R8.2
unnamed: Q1.2 (G), R1.2
unnamed: IC1.3 (+IN), R2.1
unnamed: C1.+, R2.2, R3.1
unnamed: IC1.2 (-IN), R4.1, R5.1
unnamed: IC1.6 (OUT), Q2.B, R4.2
unnamed: D2.A, IC2.3 (+IN), R6.1, R7.2
unnamed: D3.A, IC2.5 (+IN), R8.1, R9.2
OUTFAN: J1.5, R1.1
PWMFAN: D1.C, J1.3, Q1.3 (D)
PWMVOLTAGE: J1.4, R3.2
VCC: D2.C, D3.C, IC1.7 (V+), IC2.8 (V+), J1.10
VINBAT: J1.1, R7.1
VINRED: J1.8, R9.1
VOUTBATT: IC2.1 (OUT), IC2.2 (-IN), J1.9
VOUTRED: IC2.6 (-IN), IC2.7 (OUT), J1.11

Notes on the sheet:
fan controller
vcc
gnd
Input Fan Control PWM
OutPut to fan
Input Voltage PWM
Connect to 2n3055 Base
Connect to 2n3055 Collector
VinBATT
V+/RED
Vout/BATT
Vout/RED

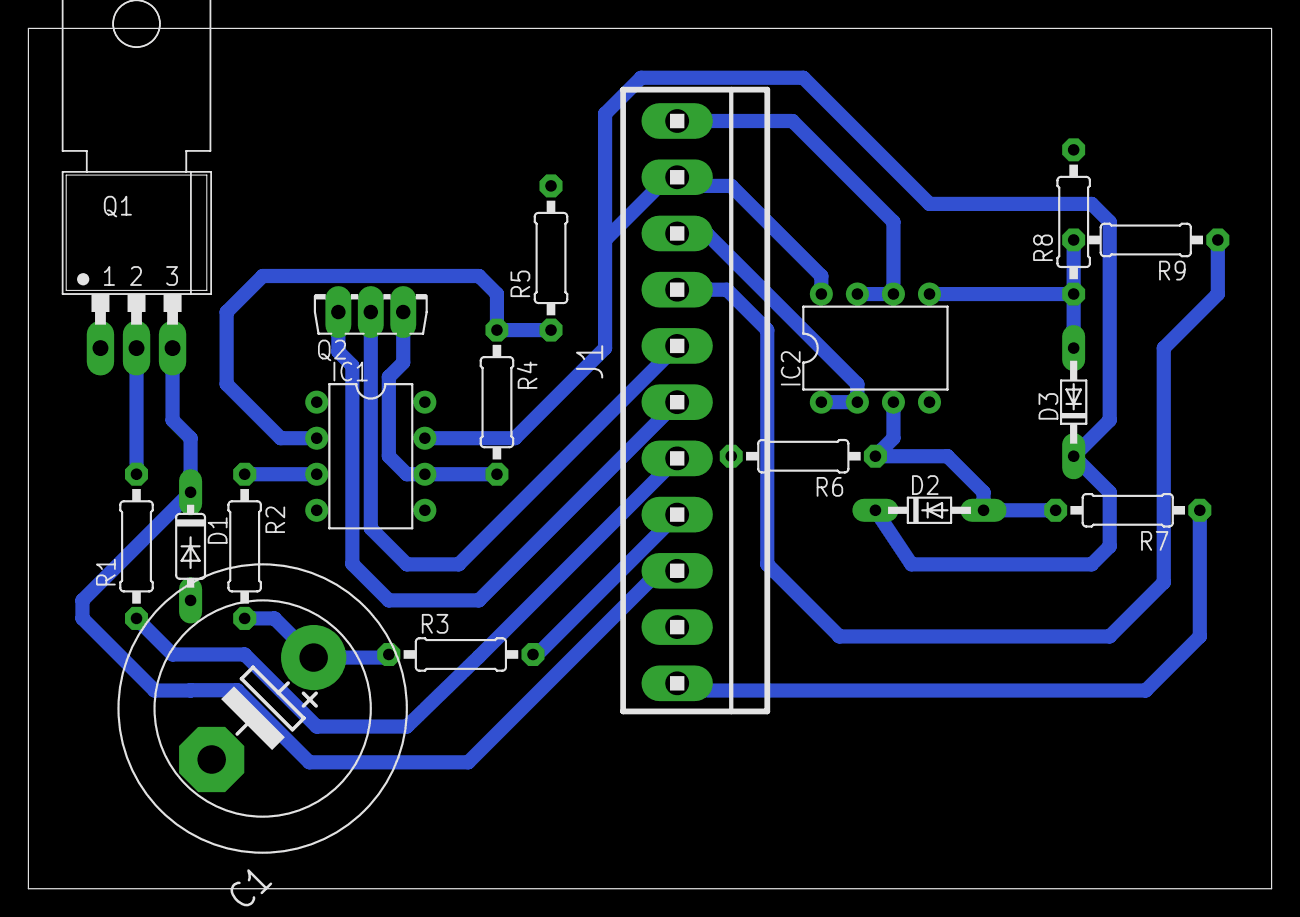
[picture p59: board pwmControl.brd from above]

Board: 2 copper layers, 87.6 x 60.6 mm, 18 parts (0 on the bottom side), 18 nets.
