MiguelHorta/SmartLeadCharger/eagle_schematics/ajuste-sensor-temperatura2.brd

## EAGLE design eagle_schematics/ajuste-sensor-temperatura2.brd (2017-05-18)

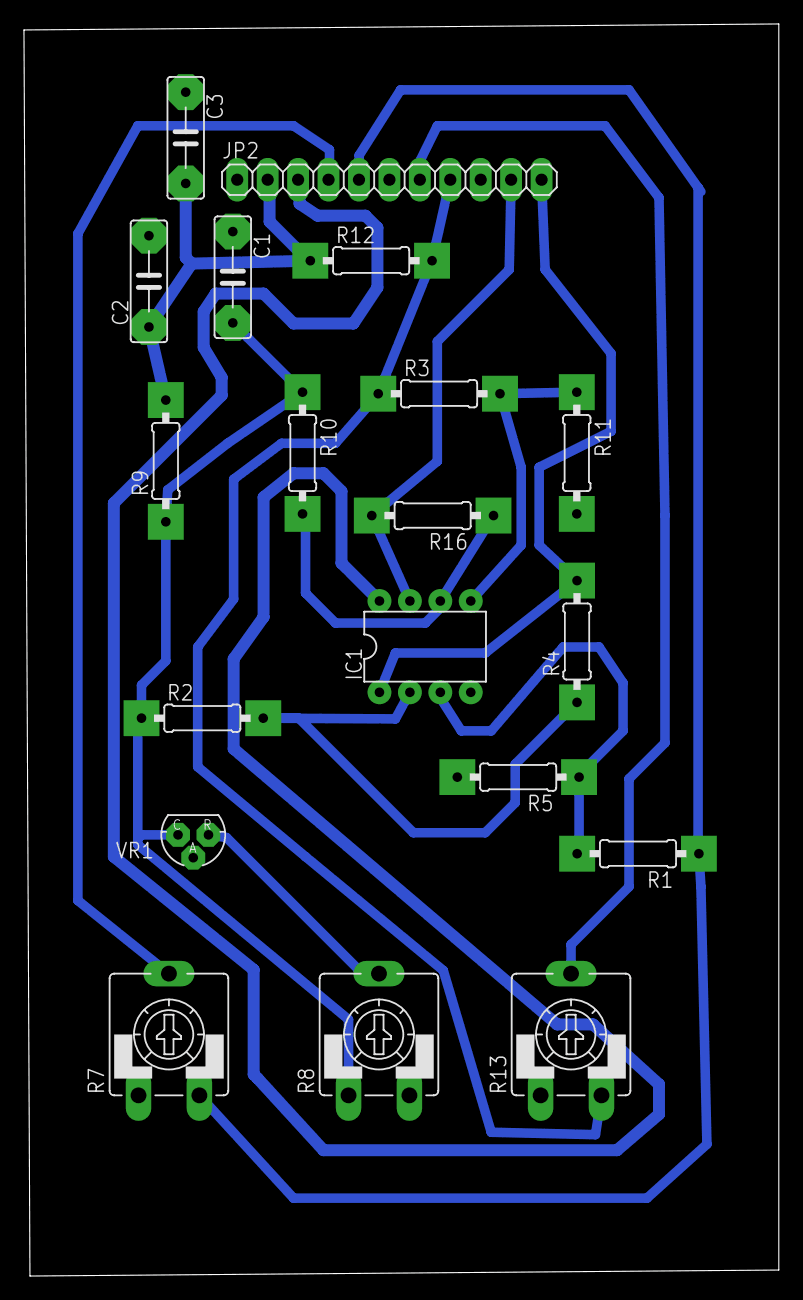
[picture p60: board ajuste-sensor-temperatura2.brd from above]

Board: 2 copper layers, 63.0 x 104.5 mm, 19 parts (0 on the bottom side), 15 nets.

Parts:
C1, C2, C3: 0.01n; C7.5B3
IC1: MCP602P; DIL08
JP2: 1X11
R1, R2, R3, R10: 33k; 0207/10
R4, R5, R11, R16: 100k; 0207/10
R7, R13: 10k; CA9V
R8: 100; CA9V
R9: 120; 0207/10
R12: 330; 0207/10
VR1: 2.5V; TO92-CLP

Connections:
AGND: C1.1, C2.2, C3.1, IC1.4, JP2.1, JP2.6, JP2.9, R5.2, R7.A, R8.E, R11.2, R13.A, VR1.A
unnamed: IC1.3, R1.2, R5.1
unnamed: IC1.2, R2.2, R4.1
unnamed: JP2.5, R1.1, R7.E
unnamed: JP2.4, R7.S
unnamed: R8.S, VR1.R
unnamed: IC1.5, R3.2, R11.1
unnamed: IC1.6, R10.2, R16.1
unnamed: JP2.8, R3.1, R12.2, R13.E
unnamed: JP2.7, R13.S
unnamed: C1.2, R2.1, R8.A, R9.1, R10.1, VR1.C
OUT$1: IC1.1, JP2.11, R4.2
OUT$2: IC1.7, JP2.10, R16.2
S$1: C2.1, C3.2, JP2.2, R9.2, R12.1
VCC: IC1.8, JP2.3
