MiguelHorta/SmartLeadCharger/(commit log)

2017-03-15 Commit de teste
2017-03-16 Finished ADC abstraction.
2017-03-16 Added printf functionality.
2017-03-16 Added PWM abstration.
2017-03-31 Test adc.
2017-04-06 Fix adc interruption routine.
    [main.c, slc_adc.c, slc_adc.h, slc_pwm.c]
2017-04-24 Fixed adc code. Implemented voltage regulator.
    [main.c, slc_adc.c, slc_adc.h, slc_util.h, slc_voltage_regulator.c, slc_voltage_regulator.h]
2017-04-25 Redo voltage regulator.
2017-05-01 esquemático e placa em eagle dos sensores de temperatura
    [ajuste-sensor-temperatura2.brd, ajuste-sensor-temperatura2.sch]
2017-05-01 esquematico e placa do medidor de corrente - Não está pronto a imprimir, tem que se alterar os MCP601X para op-amps que haja no armazem
    [current-sense.brd, current-sense.sch]
2017-05-25 Added charge panner.
2017-05-29 mais esquemáticos
    [current-sense.brd, current-sense.sch, pwmControl.brd, pwmControl.sch]
2017-06-01 Cantos 3D Model
    [E4Tetus.stl]
2017-06-05 algoritmo de controlo introduzido
2017-06-23 atualizacao de modelos 3D e esquematicos
    [Botão.fcstd, ComeBananas.fcstd, LCD.fcstd, LCD.stl, PSATX.fcstd, current-sense.brd, current-sense.sch, pwmControl.brd]
